pelmin404/B1TWatch/README.md

# B1TWatch
### A low power, Li-ion/LiPo battery powered binary watch with an exposed PCB, automatic brightness, and interactive settings based on a Seeed Studio XIAO MG24 Sense


## 🛠️ Size and design:
The board is 5 cm wide and 4.25 cm tall, with chamfered corners, and is meant to be press-fitted into a strap with a battery. For customization purposes it has an empty space on its bottom left corner reserved for graphics or extra components. By default the board has no silkscreen besides settings markings in "Silkscreen" font.

## ⚡ Power:
Because the board is using a Seeed Studio XIAO MG24 Sense, any battery that complies with [this guide](https://wiki.seeedstudio.com/xiao_mg24_getting_started/#battery-usage) can be connected to the JST connector present on the board.

**However the user needs to make sure that the positive and negative terminals on the female JST connector of the battery are in the right orientation by confirming that the side of the male JST connector on the board that will be connected to the positive wire has a trace connecting it to the XIAO. Otherwise permanent damage may be caused**

## 🎨 Customization:
The provided .ino file has lots of comments that explain what each part does and what values to change for customization. Along software, the PCB can be customized as well, mainly by using the reserved empty space. However if extra electronic components are added, the XIAO's current limits have to be accounted for.

## ⚙️ Manual:
In this manual, the rotary encoder will be referred to as a watch crown.
### Overview:
B1TWatch has 4 modes: Idle, Time, Configuration, and Calibration.
* Idle mode puts the XIAO into a power saving sleep mode and keeps its RTC active.
* Time mode shows time and opens access to Configuration and Calibration modes.
* Configuration mode lets you manage timers, alarms, and stopwatches, and change watch settings.
* Calibration mode lets you calibrate the watch manually or via Bluetooth connection to a smartphone, laptop, or a PC.

### Configuration Mode and Labels:
To access the Configuration mode, press the crown once. You will see a lit up bar indicating the chosen setting menu.



Every configuration setting is labeled with its initial from left to right in this order:
* **T**imer
* **A**larm
* **S**topwatch
* **V**olume/**F**requency
* **B**rightness
* **F**ormat

To open any setting menu, rotate the crown either way until the lit up LED bar is in line with the corresponding setting label, and press the crown once.

To exit out of any setting menu at any moment and discard all changes, press and hold the crown for 1 second by default.

### Timer:
To set a timer, enter the Configuration mode and select the Timer menu, then press the crown once. The bottom row of LEDs will light up indicating that the current selected time option is seconds. Rotate the crown either way to adjust desired time in the selected row. Press the crown once to confirm changes and select the row above, or press 2 times to select the row below. Once the desired time is set, select the hour row and press the crown once to start the timer. When the timer is active, its countdown will be displayed by default in Time mode until it is triggered or canceled. Rotate the crown in either direction to switch between viewing the current time and the timer countdown.

To change the active timer length, open the Timer menu and follow timer setup steps and set the new desired time, the active timer will keep counting down to the new time without restarting. To cancel the active timer, change its length to 0 seconds.

Note: If the new timer length is equal to or smaller than the time which it has already been active for, it will be triggered immediately.

### Alarm:
The Alarm menu has multiple steps. To revert any step past the 1st one and return to the previous step, double press the crown on the lowest selected row (if applicable).

#### Step 1:
Enter the Configuration mode and open the Alarm menu. The first step of alarm setup will be selected in this step select one out of 64 possible alarms using the crown and the bottom row of the matrix, counting in binary. If a selected alarm exists, the leftmost LED on the top row will light up. Press the crown to continue.

#### Step 2:
The bottom row of LEDs will light up indicating that the current selected time option is seconds. Rotate the crown either way to adjust desired time in the selected row. Press the crown once to confirm changes and select the row above, or press 2 times to select the row below. Once the desired time is set, select the hour row and press the crown once to continue.

#### Step 3:
Add the active weekdays for the alarm by rotating the crown and counting in binary to the corresponding weekday number, with Monday being 1 and Sunday being 7. Press the crown once to add an active day. When selecting an already active weekday, the leftmost LED on the top row will light up. Press the crown once to remove the weekday. To start will all weekdays active and subtract them instead, select weekday 0 and press the crown once. All LEDs will light up and counting will be indicated by LEDs that are off. Select weekday 0 again and press the crown once to switch back to the addition mode. Switching between these 2 modes discards changes on this step.

To apply the alarm, rotate the crown past weekday 7, an indication bar on the middle row will be displayed. Press the crown once to confirm all changes. If the bar flashes and nothing else happens, it means no weekdays are active. Otherwise an animation will be played and B1TWatch will switch to Time mode, indicating a successful operation.

To delete an alarm, select an alarm following instructions from [step 1](#step-1), set its time to 0 seconds and press the crown once. Setting selection menu will then be opened.

### Stopwatch:
To start a stopwatch, enter the Configuration mode and select the Stopwatch menu, then press the crown once. First, set a desired countdown after which the stopwatch will start. The bottom row of LEDs will light up indicating that the current selected time option is seconds. Rotate the crown either way to adjust desired countdown time in the selected row. Press the crown once to confirm changes and select the row above, or press 2 times to select the row below. Once the desired countdown time is set, select the hour row and press the crown once to start the countdown. To pause or resume the stopwatch, press the crown once. To reset the stopwatch and go back to countdown selection, double press the crown while the stopwatch is paused.

### Volume/Frequency:
To change volume and/or frequency of the piezo buzzer, enter the Configuration mode and select the Volume/Frequency menu, then press the crown once. Rotate the crown either way to adjust desired volume in increments of 10%. Once the desired time is set, select the hour row and press the crown once to continue. Then rotate the crown either way to adjust desired frequency in hHz, and press the crown once to apply changes, or twice to return to volume setting.

### Brightness:
To change the minimum and maximum brightness, enter the Configuration mode and select the Brightness menu, then press the crown once. Rotate the crown either way to adjust desired minimum brightness in increments of 10% and press the crown once to continue. Then rotate the crown either way to adjust desired maximum brightness in increments of 10%, and press the crown once to apply changes, or twice to return to minimum brightness setting.

### Format:
To change the time format, enter the Configuration mode and select the Format menu, then press the crown once. The middle row will then show a binary 12 or 24, indicating the corresponding current time format. Rotate the crown either way to change it, and press it once to confirm changes.
