pelmin404/B1TWatch/BOM.csv

Reference | Qty | Value | Description | MPN | Datasheet
BZ1 | 1 |  | Buzzers Transducer, Externally Driven Piezo 1.5 V 4kHz 84dB @ 1.5V, 10cm Surface Mount Solder Pads | PKLCS1212E4001-R1 | https://pim.murata.com/asset/pim4/piezoelectricSounderBuzzer/SPEC_PKLCS1212E4001-R1_PDF_PIEZOELECTRICSOUNDERBUZZER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
D1,D2,D3,D4,D5,D6,D7,D8,D9,D10,D11,D12,D13,D14,D15,D16,D17,D18 | 18 |  | Yellow 590nm LED Indication - Discrete 2V 0603 (1608 Metric) | APT1608SYC/J3-AMT | https://www.kingbrightusa.com/images/catalog/SPEC/APT1608SYC-J3-AMT.pdf
J1 | 1 |  | Connector Header Surface Mount, Right Angle 2 position 0.079" (2.00mm) | S2B-PH-SM4-TB | https://www.jst-mfg.com/product/pdf/eng/ePH.pdf
Q1,Q2,Q3 | 3 |  | N-Channel 20 V 2.3A (Ta) 500mW (Ta) Surface Mount PG-SOT23 | BSS806NEH6327XTSA1 | https://www.infineon.com/assets/row/public/documents/24/49/infineon-bss806ne-ds-en.pdf
R1,R2,R3,R4,R5,R6 | 6 | 56 | 56 Ohms ±1% 0.1W, 1/10W Chip Resistor 0603 (1608 Metric) Moisture Resistant Thick Film | RC0603FR-0756RL | https://yageogroup.com/content/datasheet/asset/file/PYU-RC_GROUP_51_ROHS_L
R7 | 1 | 10k | 10 kOhms ±5% 0.1W, 1/10W Chip Resistor 0603 (1608 Metric) Moisture Resistant Thick Film | RC0603JR-0710KL | https://yageogroup.com/content/datasheet/asset/file/PYU-RC_GROUP_51_ROHS_L
R8 | 1 |  | Photo cell (CdS photoresistor) | 161 | https://cdn-learn.adafruit.com/downloads/pdf/photocells.pdf
R9 | 1 | 1k | 1 kOhms ±1% 0.1W, 1/10W Chip Resistor 0603 (1608 Metric) Moisture Resistant Thick Film | RC0603FR-071KL | https://yageogroup.com/content/datasheet/asset/file/PYU-RC_GROUP_51_ROHS_L
SW1 | 1 |  | Rotary Encoder Mechanical 15 Quadrature (Incremental) Vertical | PEC11S-9213K-S0015 | https://www.bourns.com/docs/Product-Datasheets/PEC11S.pdf
U1 | 1 |  | EFR32MG24 Mighty Gecko 802.15.4 (Matter, Thread, Zigbee®), Bluetooth® 5.x (BLE) Transceiver 2.4GHz Evaluation Board | 102010610 | https://files.seeedstudio.com/Bazaar/product_pdf/102010590.pdf
