pelmin404/B1TWatch/pcb/B1TWatch.kicad_pcb

## KiCad design pcb/B1TWatch.kicad_pcb (2026-10-17)

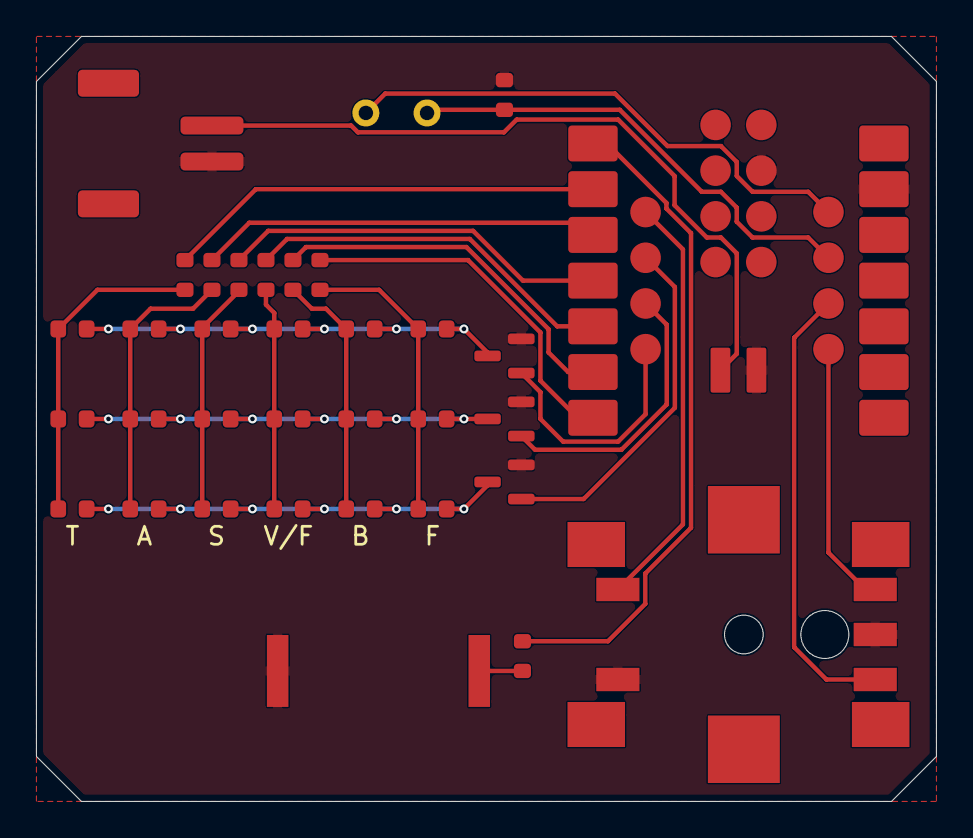
[picture p1: board B1TWatch.kicad_pcb from above]

Board: 2 copper layers, 50.0 x 42.5 mm, 34 parts (0 on the bottom side), 27 nets.

Parts:
BZ1: Buzzer; Buzzer_Murata_PKLCS1212E
D1, D2, D3, D4, D5, D6, D7, D8, D9, D10, D11, D12, D13, D14, D15, D16, D17, D18: LED; LED_0603_1608Metric
J1: Conn_01x02_Pin; JST_PH_S2B-PH-SM4-TB_1x02-1MP_P2.00mm_Horizontal
Q1, Q2, Q3: Q_NMOS_GSD; SOT-23
R1, R2, R3, R4, R5, R6: 56; R_0603_1608Metric
R7: 10k; R_0603_1608Metric
R8: LDR07; R_LDR_5.1x4.3mm_P3.4mm_Vertical
R9: 1k; R_0603_1608Metric
SW1: RotaryEncoder_Switch; PEC11S9213KS0015
U1: XIAO-MG24-SMD

Connections:
GND: BZ1.2 (-), J1.2, Q1.2 (S), Q2.2 (S), Q3.2 (S), R7.2, SW1.C, SW1.S1, U1.13 (GND), U1.29 (GND), U1.32 (GND)
unnamed: BZ1.1 (+), R9.1
unnamed: D1.2 (A), D7.2 (A), D13.2 (A), R6.1
unnamed: D1.1 (K), D2.1 (K), D3.1 (K), D4.1 (K), D5.1 (K), D6.1 (K), Q3.3 (D)
unnamed: D4.2 (A), D10.2 (A), D16.2 (A), R3.1
unnamed: D7.1 (K), D8.1 (K), D9.1 (K), D10.1 (K), D11.1 (K), D12.1 (K), Q2.3 (D)
unnamed: D5.2 (A), D11.2 (A), D17.2 (A), R2.1
unnamed: D6.2 (A), D12.2 (A), D18.2 (A), R1.1
unnamed: D13.1 (K), D14.1 (K), D15.1 (K), D16.1 (K), D17.1 (K), D18.1 (K), Q1.3 (D)
unnamed: D2.2 (A), D8.2 (A), D14.2 (A), R5.1
unnamed: D3.2 (A), D9.2 (A), D15.2 (A), R4.1
unnamed: J1.1, U1.31 (BAT)
unnamed: Q1.1 (G), U1.19 (D15)
unnamed: Q2.1 (G), U1.20 (D16)
unnamed: Q3.1 (G), U1.21 (D17)
unnamed: R9.2, U1.1 (D0)
unnamed: R1.2, U1.2 (D1)
unnamed: R2.2, U1.3 (D2)
unnamed: R3.2, U1.4 (D3)
unnamed: R4.2, U1.5 (D4)
unnamed: R5.2, U1.6 (D5)
unnamed: R6.2, U1.7 (D6)
unnamed: R8.1, U1.15 (D11)
unnamed: R7.1, R8.2, U1.16 (D12)
unnamed: SW1.A, U1.17 (D13)
unnamed: SW1.B, U1.18 (D14)
unnamed: SW1.S2, U1.22 (D18)
