pelmin404/B1TWatch/(commit log)

2026-10-17 add pcb files
    [B1TWatch.csv, B1TWatch.kicad_pcb, B1TWatch.kicad_sch]
2026-10-17 add example gerbers
    [B1TWatch-B_Cu.gbr, B1TWatch-B_Mask.gbr, B1TWatch-Edge_Cuts.gbr, B1TWatch-F_Cu.gbr, B1TWatch-F_Mask.gbr, B1TWatch-F_Paste.gbr, B1TWatch-F_Silkscreen.gbr, B1TWatch-NPTH.drl]
2026-11-04 relocate BOM.csv
    [BOM.csv]
